eSpark-Backup/enlilishaya-windmillcircuit/Design-Files/Design-v2.1/Deliverables/Impedance profile/50 Ohms net_names.PNG

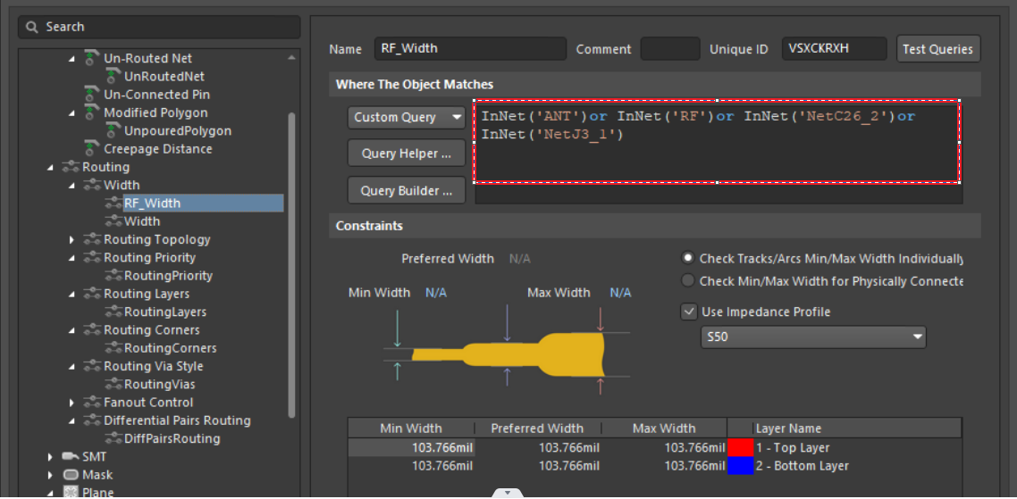
Design-Files/Design-v2.1/Deliverables/Impedance profile/50 Ohms net_names.PNG
