eSpark-Backup/enlilishaya-windmillcircuit/Design-Files/Design-v2.1/Deliverables/Renderings/3D_Top_View.PNG

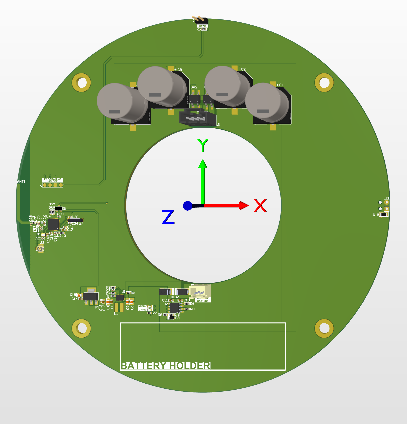
Design-Files/Design-v2.1/Deliverables/Renderings/3D_Top_View.PNG
