eSpark-Backup/enlilishaya-windmillcircuit/Design-Files/Design-v2.1/Deliverables/Renderings/Dimension.PNG

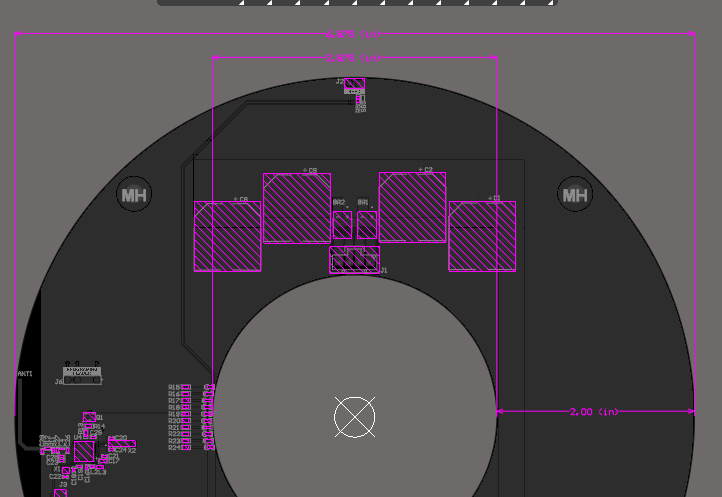
Design-Files/Design-v2.1/Deliverables/Renderings/Dimension.PNG
