eSpark-Backup/enlilishaya-windmillcircuit/Design-Files/Design-v2.1/Deliverables/BOM/Client-BOM-Design-v2.1.xlsx

# | Item Type | Designator | Description | Footprint | Manufacturer Part Number | Manufacturer | Value | Quantity | Remarks
1 | Bridge Rectifier | BR1, BR2 | 50A 700mV@2A 2A 60V MBS Bridge Rectifiers ROHS | Custom | MB26S | MDD | - | 2
2 | Capacitor | C1, C2, C8, C9 | 2200uF 25V 720mA@120Hz ±20% SMD,D16xL16.5mm Aluminum Electrolytic Capacitors - SMD ROHS | Custom | VT1E222M1616 | ROQANG | 2200uF | 4
3 | Capacitor | C3, C10, C11, C12, C14 | CAP CER 10UF 16V X5R 0603 | Cap-0603 | CC0603KRX5R7BB106 | Yageo | 10uF | 5
4 | Capacitor | C4 | CAP CER 47UF 10V X5R 0805 | Cap-0805 | GRM21BR61A476ME15L | Murata | 47uF | 1
5 | Capacitor | C5, C6, C15 | CAP CER 22UF 25V X5R 0805 | Cap-0805 | CC0805MKX5R8BB226 | Yageo | 22uF | 3
6 | Capacitor | C7, C13, C19, C21, C29 | CAP CER 0.1UF 50V X7R 0402 | cap-0402 | C1005X7R1H104KT000F | TDK | 100nF | 5
7 | Capacitor | C16 | CAP CER 1UF 25V X5R 0402 | Cap-0402 | CL05A105KA5NQNC | Samsung | 1uF | 1
8 | Capacitor | C17 | CAP CER 4.7UF 25V X5R 0603 | Cap-0603 | CL10A475KA8NQNC | Samsung | 4.7UF | 1
9 | Capacitor | C18, C22 | CAP CER 12PF 50V C0G/NP0 0402 | Cap-0402 | GJM1555C1H120GB01D | Murata | 12pF | 2
10 | Capacitor | C20, C24 | 50V 9pF C0G 0402 Multilayer Ceramic Capacitors MLCC - SMD/SMT ROHS | Cap-0402 | 0402CG9R0C500NT | FH (Guangdong Fenghua Advanced Tech) | 9pF | 2
11 | Capacitor | C23 | CAP CER 100PF 50V C0G/NPO 0402 | Cap-0402 | CC0402JRNPO9BN101 | Yageo | 100pF | 1
12 | Capacitor | C25, C27 | CAP CER 0.1UF 50V X7R 0402 | cap-0402 | C1005X7R1H104KT000F | TDK | DNP | 2 | DO NOT PLACE
13 | Capacitor | C26 | CAP CER 0.8PF 50V C0G/NPO 0402 | Cap-0402 | CC0402BRNPO9BNR80 | Yageo | 0.8pF | 1
14 | Capacitor | C28 | CAP CER 1.2PF 50V C0G/NPO 0402 | Cap-0402 | CC0402BRNPO9BN1R2 | Yageo | 1.2pF | 1
15 | Diode | D1, D2 | 60V 700mV@2A 2A SMA(DO-214AC) Schottky Barrier Diodes (SBD) ROHS | SMA(DO-214AC) | SS26 | MDD | - | 2
16 | Diode | D3 | DIODE ZENER 3.3V 200MW SOD323F | SOD323F | MM3Z3V3B | ON Semiconductor / Fairchild | - | 1
17 | Wire to Board Connector | J1 | 1x4P 4P 1 Tin 2.54mm 4 3A Brass Direct Insert Plugin,P=2.54mm Wire To Board Connector ROHS | Custom | X9556WV-04-N0V01 | XKB Connection | - | 1
18 | Male Header | J2 | Gold 250V 3A Straight Square Pins 2.5mm 2P 260℃ 6mm -40℃~+105℃ 3mm 2.54mm Plugin Black Brass 1x2P Plugin,P=2.54mm Pin Headers ROHS | HDR1X2_ | X6511WV-02H-C60D30 | XKB | - | 1
19 | UFL Connector | J3 | CONN U.FL RCPT STR 50 OHM SMD | Custom | U.FL-R-SMT-1(80) | Hirose | - | 1
20 | JST Connector | J5 | Conn Shrouded Header (4 Sides) HDR 2 POS 2.5mm Solder ST Thru-Hole Box | Custom | B2B-XH-A(LF)(SN) | JST | - | 1
21 | Pogo Connector | J6 | Pogo Pad 2.5mm 4 Pin | Custom | POGO Connector 4 Pin |  | - | 1
22 | Inductor | L1 | 6A 1.5uH ±20% 10.5A SMD,4.1x4.1mm Power Inductors ROHS | Custom | FTC404020S1R5MGCA | cjiang (Changjiang Microelectronics Tech) | 1.5uH | 1
23 | Inductor | L2 | FIXED IND 15NH 400MA 0.45OHM SMD | IND-0402 | LQG15HN15NJ02D | Murata | 15nH | 1
24 | Inductors | L3 | FIXED IND 10UH 80MA 360 MOHM SMD | IND-0603 (1608 Metric) | LBMF1608T100K | Taiyo Yuden | 10uH | 1
25 | Inductors | L4 | FIXED IND 3.9NH 350MA 350MOHM SM | IND-0201 | LQP03TG3N9B02D | Murata | 3.9nH | 1
26 | LED | LED1 | Emerald 0603 Light Emitting Diodes (LED) ROHS | LED-0603 | NCD0603G2 | Foshan NationStar Optoelectronics | - | 1
27 | LED | LED2 | RED LED 0603 Light Emitting Diodes | LED-0603 | NCD0603R3 | Foshan NationStar Optoelectronics | - | 1
28 | Mosfet | Q1 | Trans Mosfet P-ch 30V 4A 3-PIN SOT-23 T/r | SOT-23 | AO3401A | Alpha & Omega Semiconductor | - | 1
29 | Resistor | R1 | RES SMD 523K OHM 0.1% 1/10W 0603 | Res-0603 | RT0603BRD07523KL | Yageo | 523K | 1
30 | Resistor | R2 | RES 100K OHM 1% 1/10W 0603 | Res-0603 | RC0603FR-07100KL | Yageo | 100K | 1
31 | Resistor | R3, R10, R14 | RES SMD 10K Ohm 1% 1/10W 0603 | Res-0603 | RC0603FR-0710KL | Yageo | 10K | 3
32 | Resistor | R4 | RES SMD 100K OHM 0.1% 1/10W 0603 | Res-0603 | RT0603BRD07100KL | Yageo | 100K | 1
33 | Resistor | R5 | RES SMD 330R 100 mW 0603 | Res-0603 | RC0603JR-07330RL | Yageo | 330R | 1
34 | Resistor | R6 | RES 0.47 OHM 5% 1/10W 0603 | Res-0603 | RL0603JR-070R47L | Yageo | 0.47R | 1
35 | Resistor | R7 | RES SMD 1K OHM 1% 1/10W 0603 | Res-0603 | RC0603FR-071KL | Yageo | 1K | 1
36 | Resistor | R8 | RES SMD 2K OHM 1% 1/10W 0603 | Res-0603 | RC0603FR-072KL | Yageo | 2K | 1
37 | Resistor | R9 | RES SMD 33K OHM 0.1% 1/10W 0603 | Res-0603 | RT0603BRD0733KL | Yageo | 33K | 1
38 | Resistor | R11 | RES 0 OHM JUMPER 1/16W 0402 | Res-0402 | RC0402FR-070RL | Yageo | DNP | 1 | DO NOT PLACE
39 | Resistor | R12 | RES 0 OHM JUMPER 1/16W 0402 | Res-0402 | RC0402FR-070RL | Yageo | 0R | 1
40 | Resistor | R13 | RES 4.7 OHM 1% 1/10W 0603 | Res-0603 | RC0603FR-074R7L | Yageo | 4.7R | 1
41 | Resistor | R15 | RES 8.2 OHM 1% 1/4W 1206 | Res-1206 | RC1206FR-078R2L | Yageo | 8.2R | 1
42 | IC | U1 | IC REG BCK BST ADJ 3.6A 15VQFN | VQFN-15-HR(2.5x3) | TPS63070RNMR | Texas Instruments | - | 1
43 | IC | U2 | 3.7V~6.5V Lithium-ion 1 1000mA ESOP-8 Battery Management ROHS | ESOP-8 | TP4056 | UMW(Youtai Semiconductor Co., Ltd.) | - | 1
44 | IC | U3 | 15V 1.3V @ 800mA Fixed 3.3V SOT-223 Linear Voltage Regulators (LDO) ROHS | SOT- 223 | AZ1117CH-3.3TRG1 | Diodes Incorporated | - | 1
45 | IC | U4 | IC RF TXRX+MCU BLE 32QFN | 32-QFN (5x5) | NRF52810-QCAA-R | Nordic Semiconductor | - | 1
46 | Crystal | X1 | CRYSTAL 32.0000MHZ 8PF SMD | SMD2016-4P | Q22FA12800025 | Epson | 32MHz | 1
47 | Crystals | X2 | 32.768kHz 7pF ±20ppm MC-146 Crystals ROHS | MC-146_ | Q13MC14620001 | Seiko Epson | 32.768kHz | 1
48 | Peripheral | - | Zetiling High Power Led Chip | - | B07TKL2JRM | Zetiling | - | 10 | B07TKL2JRM (https://www.amazon.com/dp/B01DBZI2A0?previewDohEventScheduleTesting=C&csmig=1)
48 | Peripheral | - | Sanyo Stepper Motor w/ 17.5mm 20 Tooth Gear - 12 V - 7.5 deg / step - 42mm D | - | B00224 | Sanyo | - | 1 | B00224 (https://www.ebay.com/itm/284742127006)
