eSpark-Backup/enlilishaya-windmillcircuit/Design-Files/Design-v2.1/Deliverables/Supporting Files/Windmill_Circuit_v2.1.step

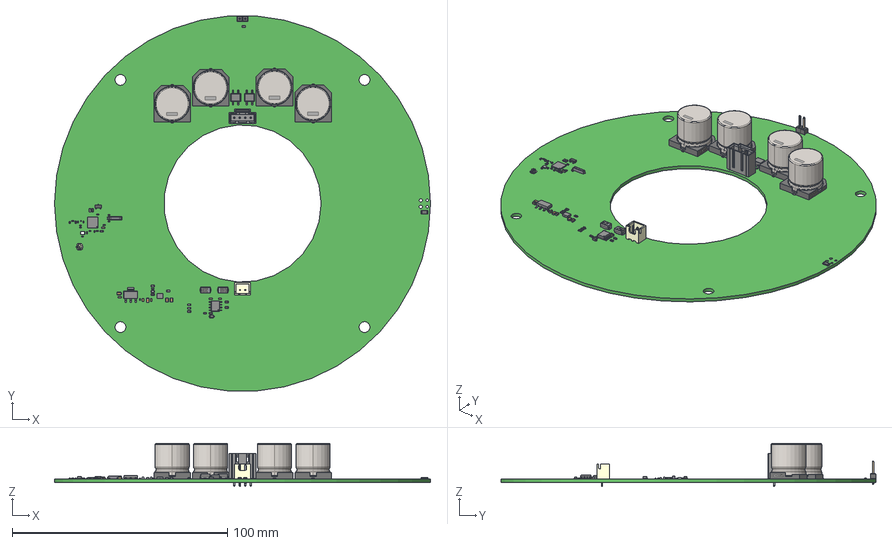
[picture p10: CAD file, 2025-07-11]
Design-Files/Design-v2.1/Deliverables/Supporting Files/Windmill_Circuit_v2.1.step
174.6 x 174.1 x 20.0 mm
User Library-SOD323F-1
User Library-CR3216-1206
User Library-RESC1608X05N x 12
CircuitWorks-SOT-23
Crystal_SMD_SeikoEpson_MC146-4Pin_6.7x1.5mm x 4
TCA6424ARGJR
User Library-SOT-223-1
User Library-RES_1005-0402 x 2
Ferrite
Lötende x 2
base
User Library-d0402h025
User Library-Capacitor 0402 x 15
User Library-CAPC1608X09 x 6
User Library-0805 SMD Capacitor x 4
TP4056-42-ESOP8--3DModel-STEP-56544
TPS63070RNMR--3DModel-STEP-56544
User Library-LED SMD0603 x 2
B2B-XH-A(LF)(SN)--3DModel-STEP-56544
U.FL-R-SMT-1
User Library-Header1x2_Header1_1 x 2
SMA (DO-214AC) x 2
SOLID.step x 2
