eSpark-Backup/enlilishaya-windmillcircuit/(list of files, cad)

Other CAD files:
Design-Files/Design-v2.1/Deliverables/Supporting Files/Windmill_Circuit_v2.1.DWG
Design-Files/Design-v2.1/Deliverables/Supporting Files/Windmill_Circuit_v2.1.DXF
