eSpark-Backup/enlilishaya-windmillcircuit/Design-Files/Design-v2.1/Schematic/Design-v2.1.pdf

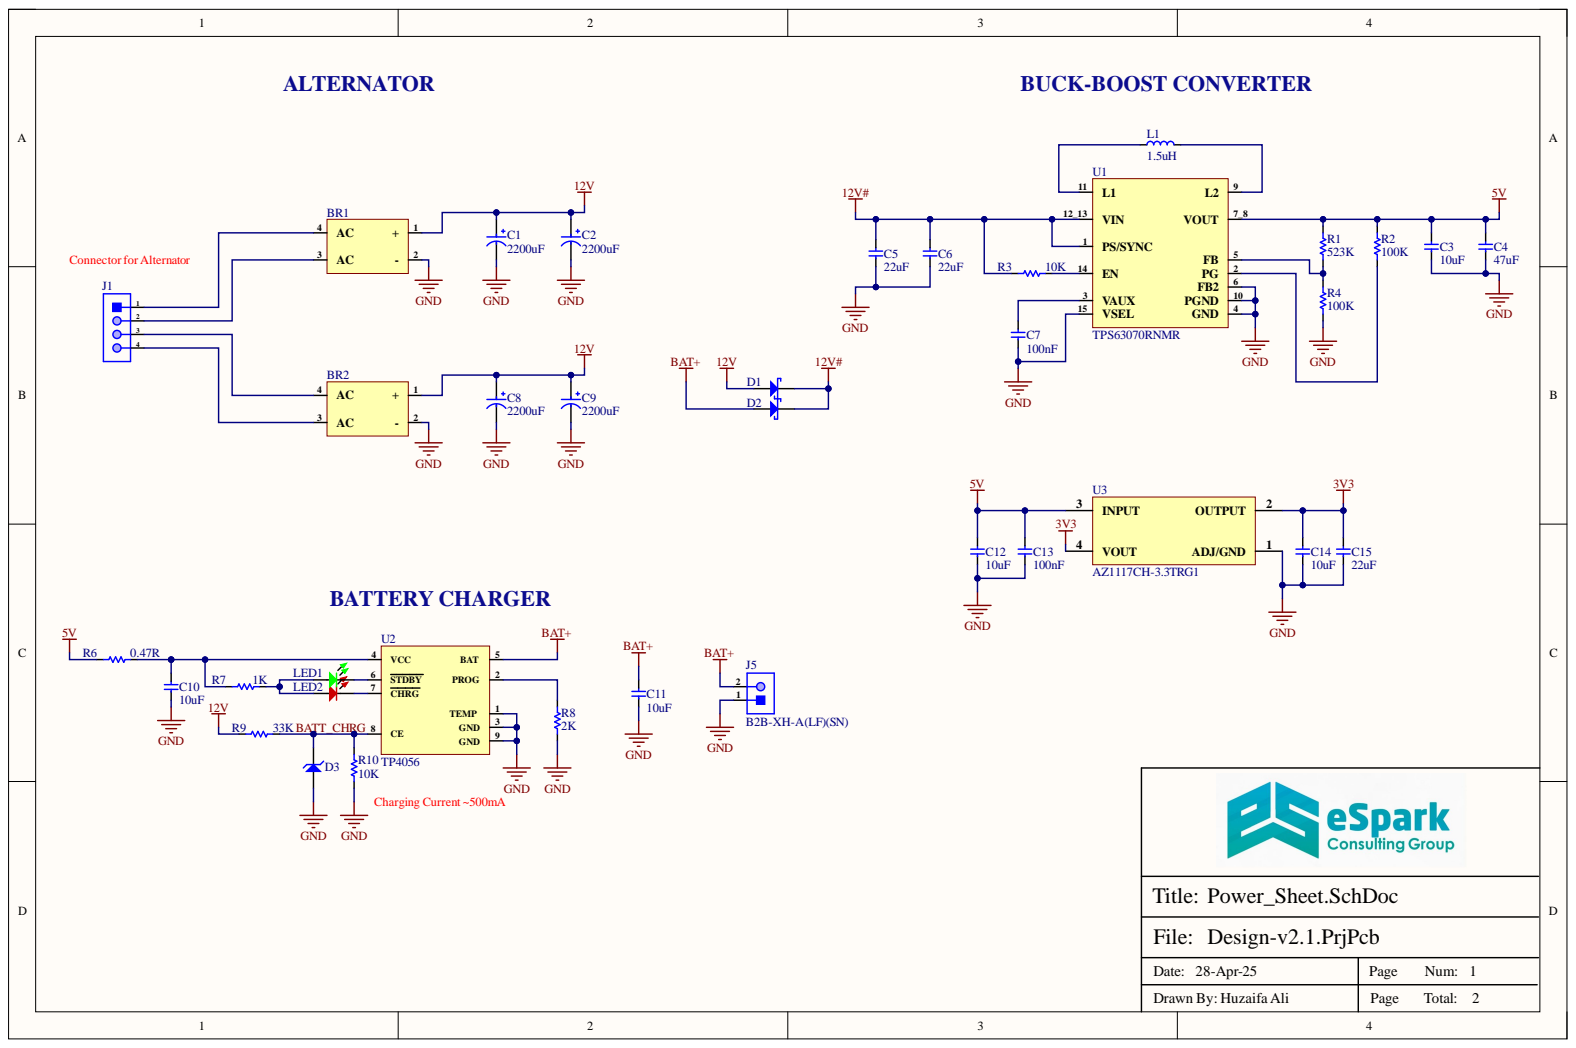
[picture p11: page 1]

Dat e : 2 8 -A p r-2 5 | Pag e N u m : 12

D raw n B y : H uzai fa A l i | Pag e To t al :

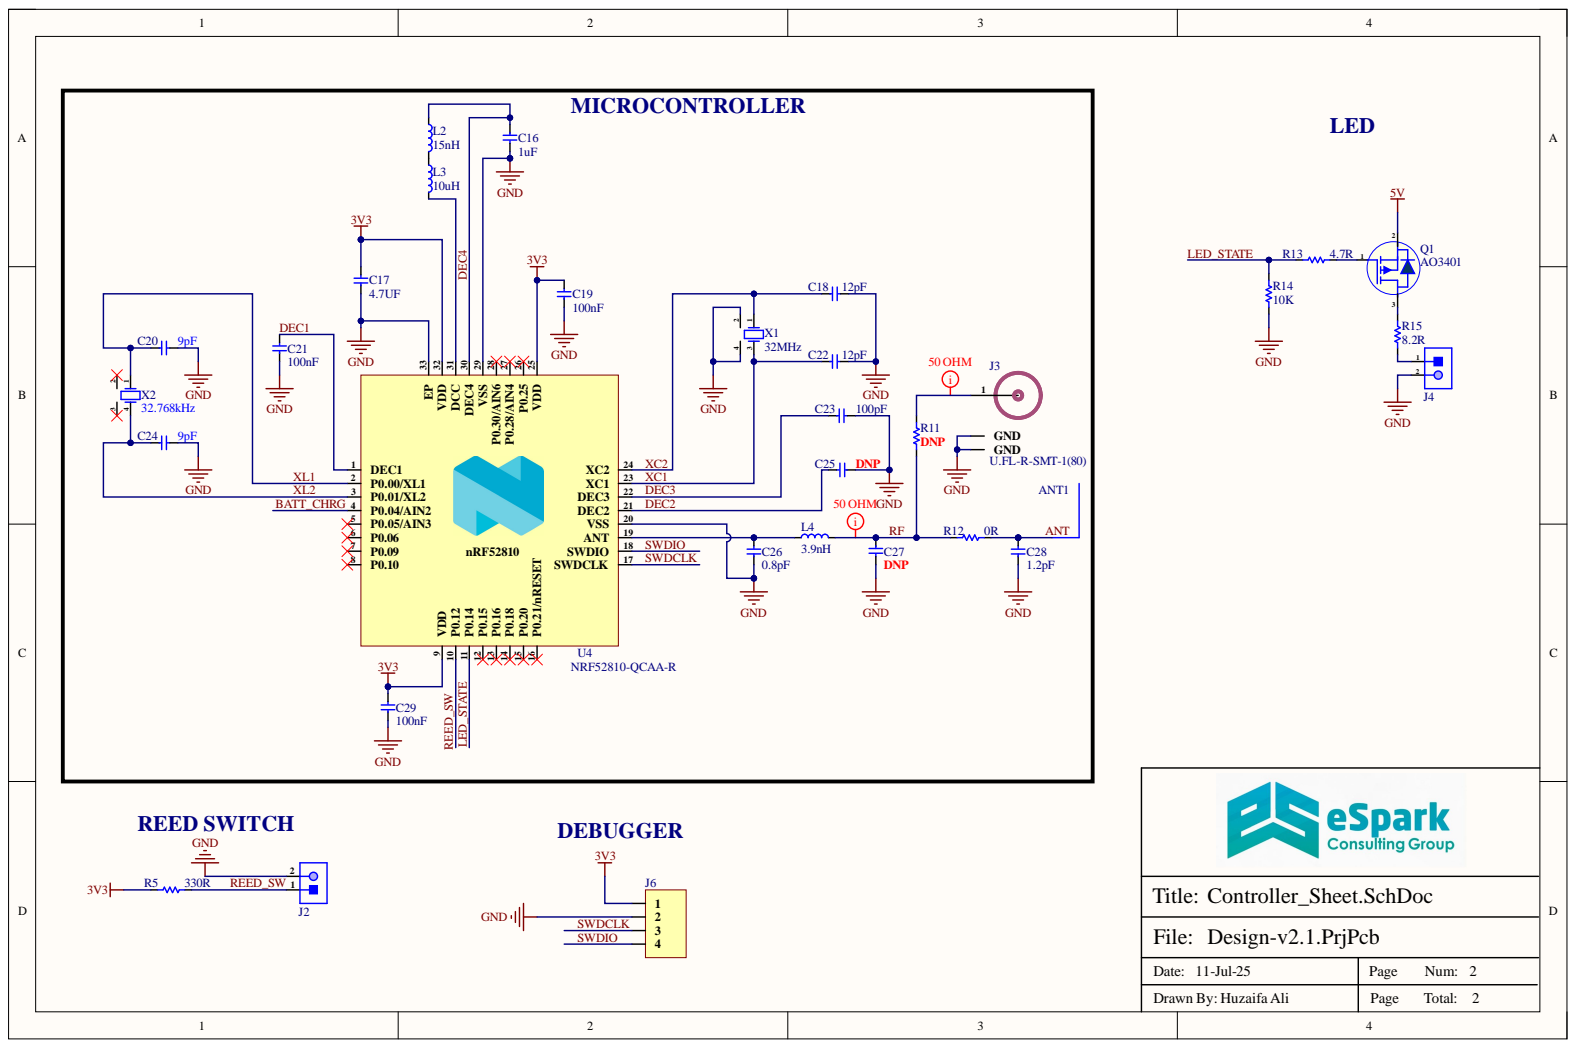
[picture p12: page 2]

Dat e : 1 1 -Ju l -2 5 | Pag e N u m : 22

D raw n B y : H uzai fa A l i | Pag e To t al :
