eSpark-Backup/enlilishaya-windmillcircuit/Design-Files/Design-v2.1/Deliverables/Schematics/Assembly_Drawing.pdf

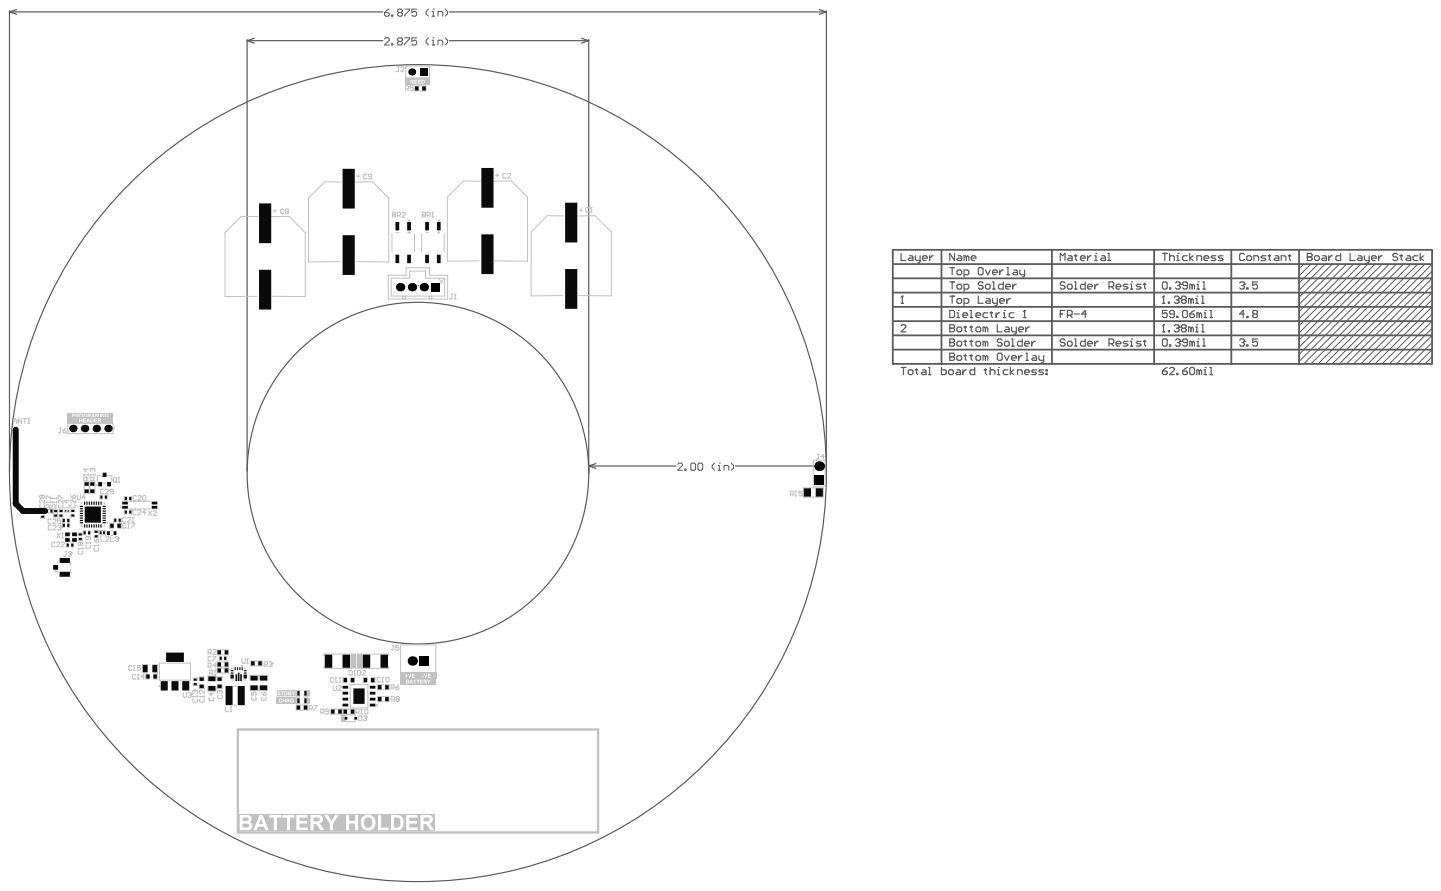
[picture p13: page 1]

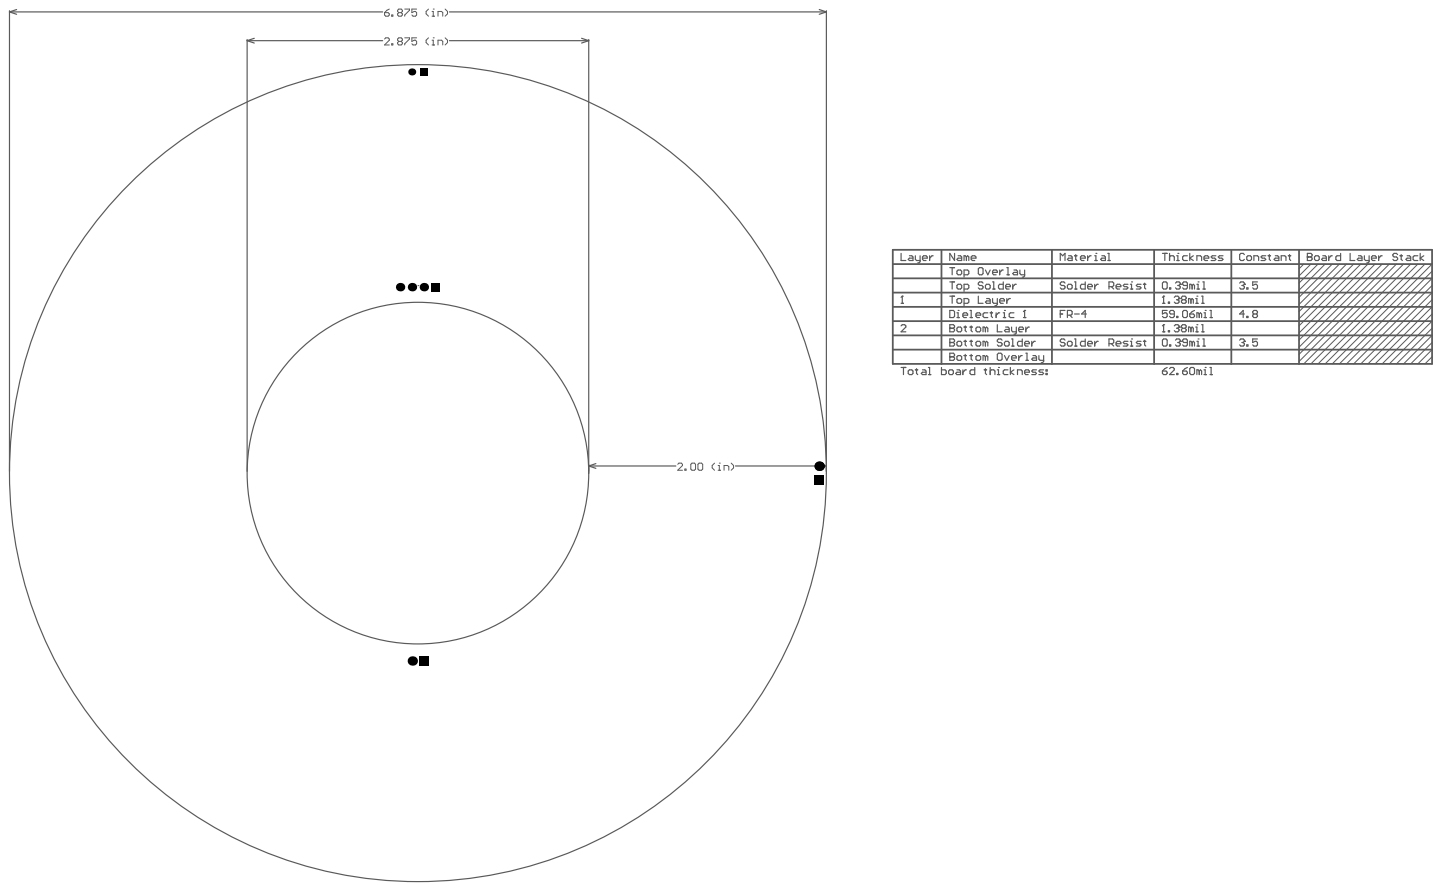
[picture p14: page 2]
