eSpark-Backup/enlilishaya-windmillcircuit/Design-Files/Design-v2.1/Deliverables/Schematics/Design-v2.1.pdf

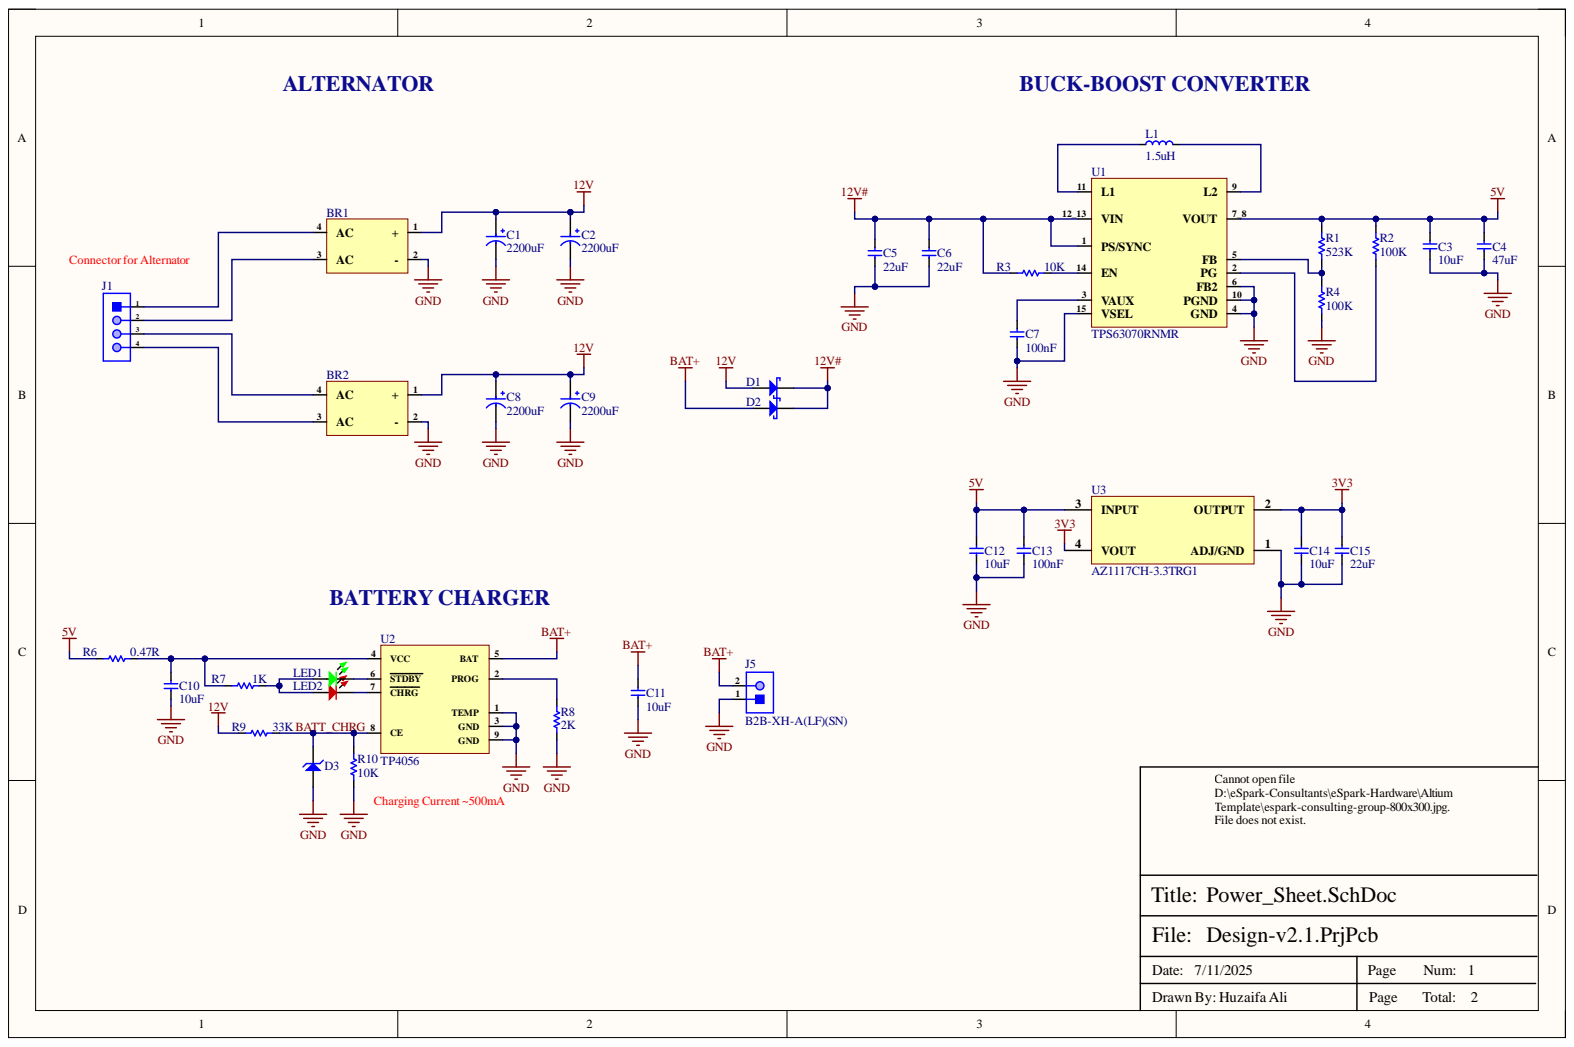
[picture p15: page 1]

Dat e : 7 / 1 1 / 2 0 2 5 | Pag e N u m : 12

D raw n B y : H uzai fa A l i | Pag e To t al :

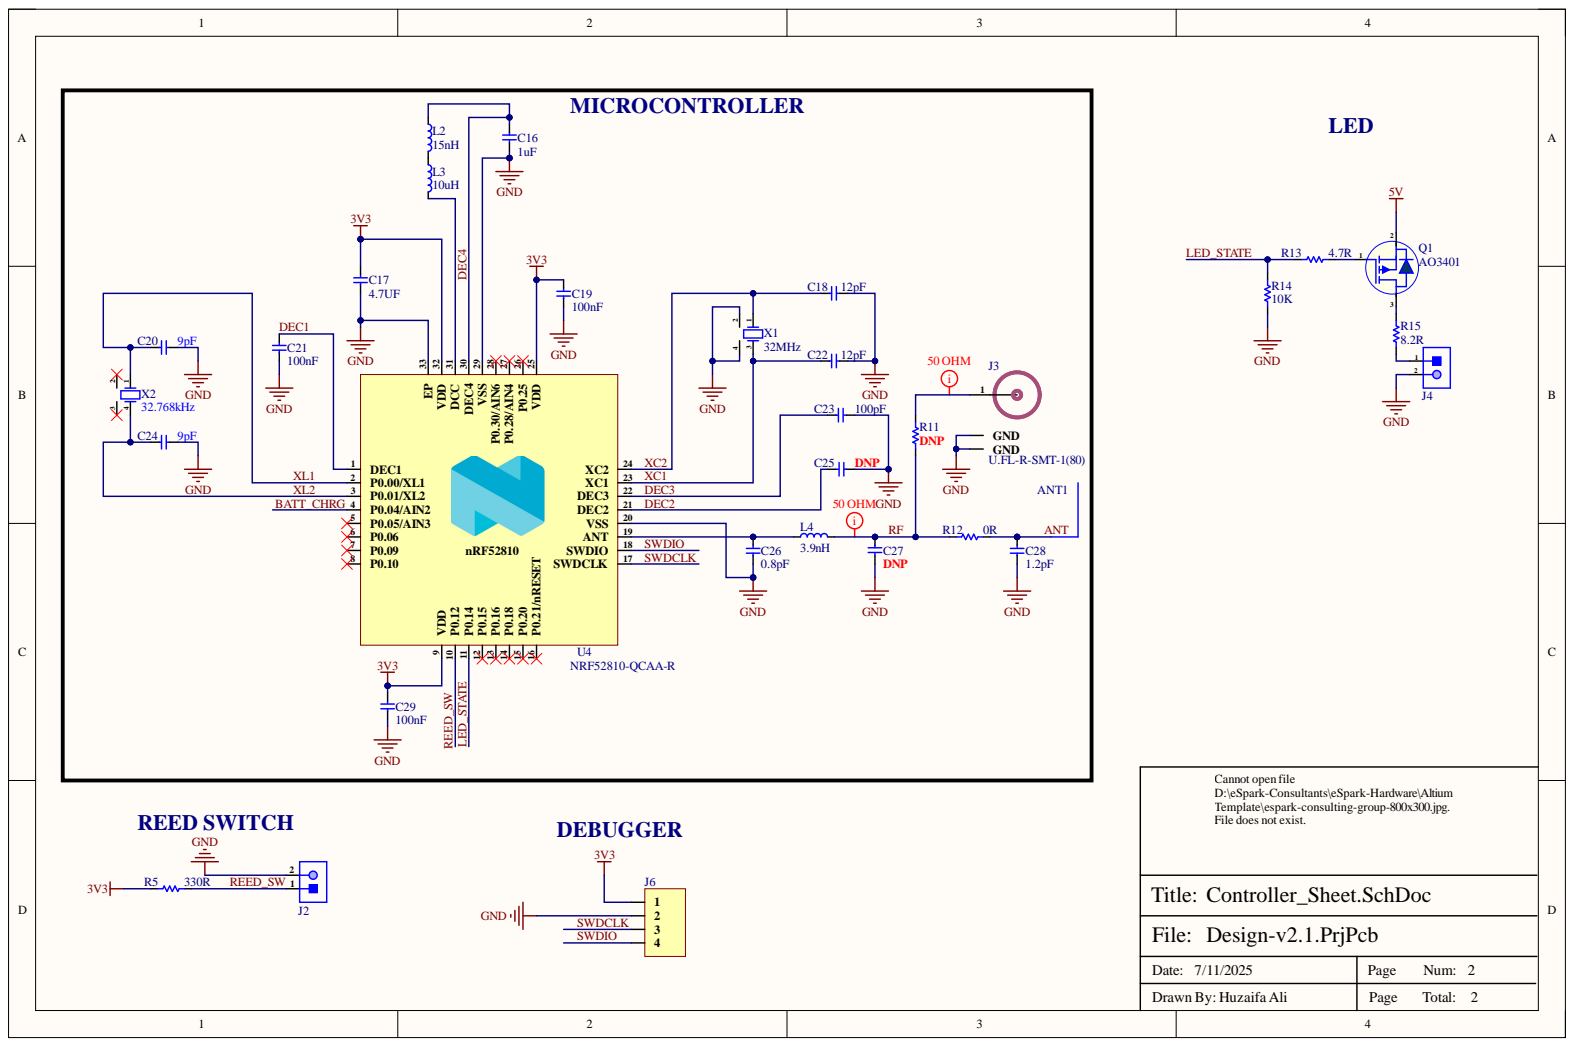
[picture p16: page 2]

Dat e : 7 / 1 1 / 2 0 2 5 | Pag e N u m : 22

D raw n B y : H uzai fa A l i | Pag e To t al :

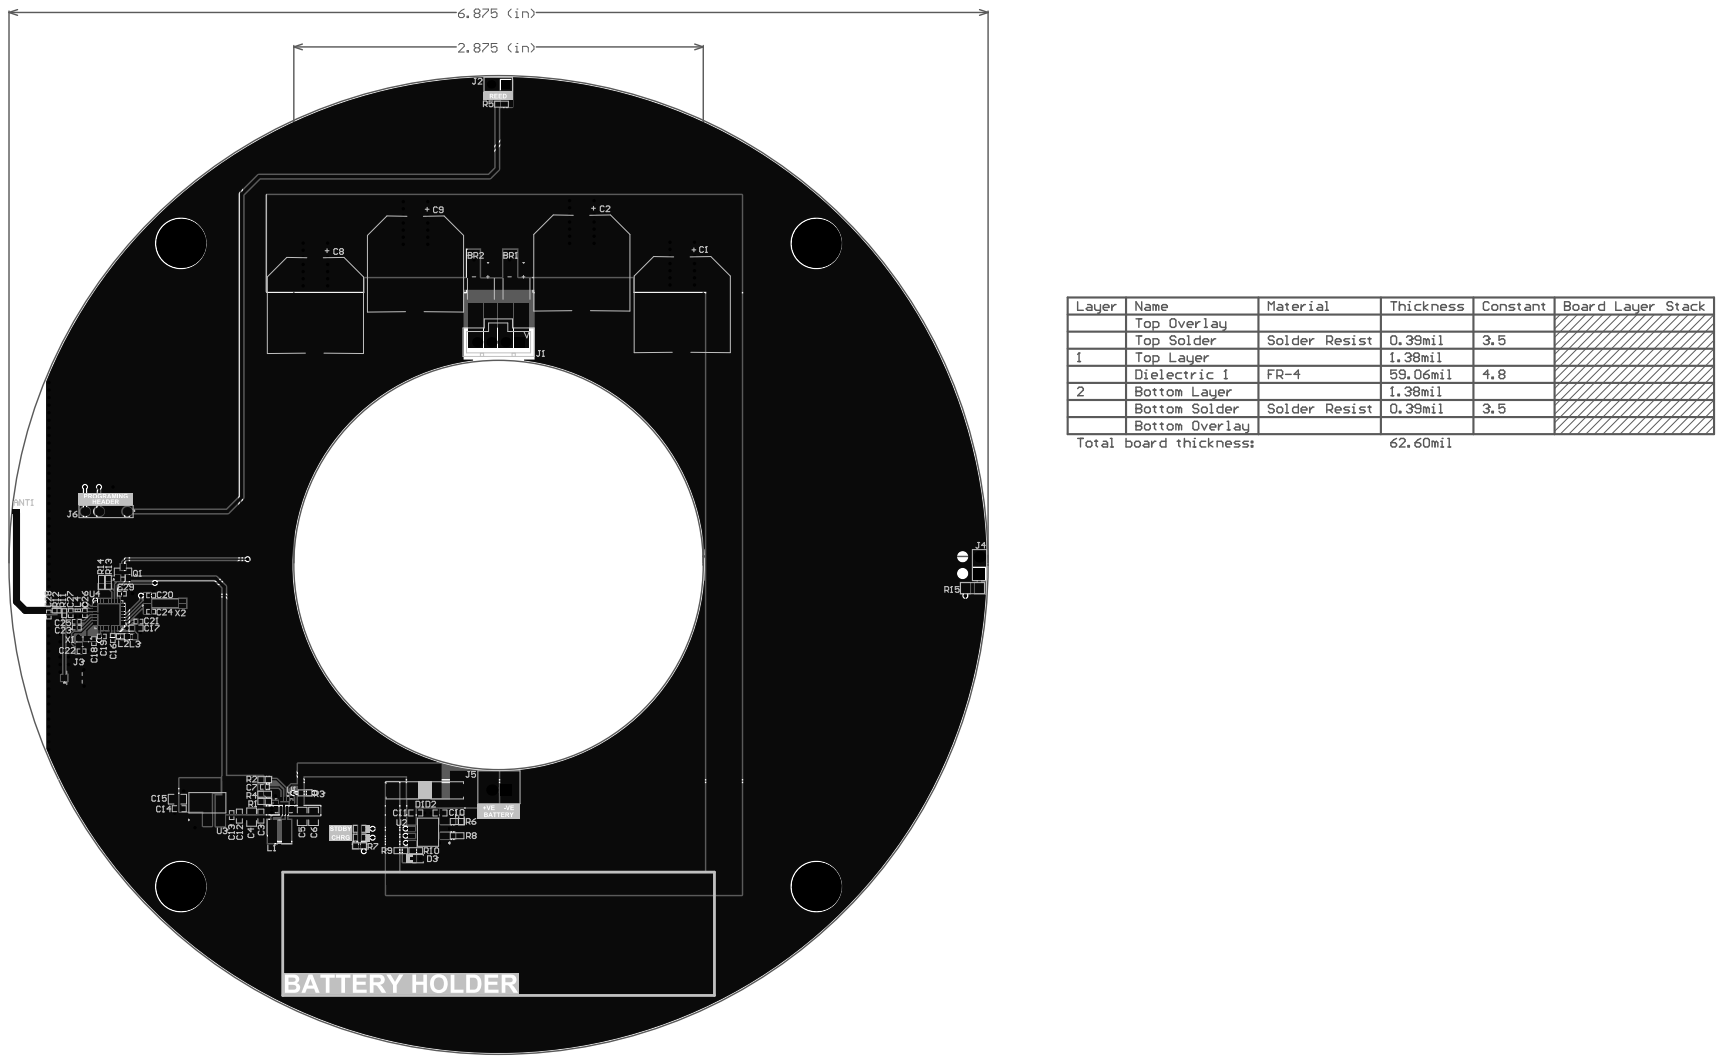
[picture p17: page 3]
