eSpark-Backup/enlilishaya-windmillcircuit/(list of files, drawings)

Other design files:
Design-Files/Design-v1.0/Design-v1.0.PrjPcb
Design-Files/Design-v2.0/Design-v2.0.PrjPcb
Design-Files/Design-v2.1/Controller_Sheet.SchDoc
Design-Files/Design-v2.1/Design-v2.1.PrjPcb
Design-Files/Design-v2.1/Power_Sheet.SchDoc
Design-Files/Design-v2.1/Windmill_Circuit_v2.1.PcbDoc
