eSpark-Backup/enlilishaya-windmillcircuit/(commit log)

2025-04-07 #2 Complete
    [Design-v1.0.PrjPcb, Sheet1.SchDoc]
2025-04-07 #2 Resistor Update. PDF Generated.
    [Design-v1.0.PrjPcb, Sheet1.SchDoc]
2025-04-08 #3 In progress
    [Design-v1.0.PrjPcb, Windmill_Circuit_v1.0.PcbDoc]
2025-04-09 #5 Schematic completed
    [Controller_Sheet.SchDoc, Design-v2.0.PrjPcb, Power_Sheet.SchDoc, Sheet1.SchDoc]
2025-04-10 #5 schematic in progress
    [Controller_Sheet.SchDoc, Windmill_Circuit_v1.0.PcbDoc]
2025-04-11 #5 led circuit added
    [Controller_Sheet.SchDoc]
2025-04-11 #6 placement completed
    [Controller_Sheet.SchDoc, Windmill_Circuit_v1.0.PcbDoc]
2025-04-14 #6 In progress
    [Windmill_Circuit_v1.0.PcbDoc]
2025-04-16 #6 Completed Deliverables Generated
    [Centroid_File.csv, Design-v2.0.PrjPcb, Pick Place for Windmill_Circuit_v2.0.csv, Power_Sheet.SchDoc, Windmill_Circuit_v1.0.PcbDoc, Windmill_Circuit_v2.0.DWG, Windmill_Circuit_v2.0.DXF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]
2025-04-24 #6 PCB updated acc: #7 Deliverables Generated
    [Centroid_File.csv, Client_BOM-v2.0.xlsx, Controller_Sheet.SchDoc, Design-v2.0.PrjPcb, Pick Place for Windmill_Circuit_v2.0.csv, Power_Sheet.SchDoc, Windmill_Circuit_v2.0.DWG, Windmill_Circuit_v2.0.DXF]
2025-04-28 #7 TH pads added in schematic
    [Controller_Sheet.SchDoc, Design-v2.0.PrjPcb, Windmill_Circuit_v2.0.PcbDoc]
2025-04-29 #7 PCB updated nd Deliverables generated
    [Centroid_File.csv, Design-v2.0.PrjPcb, Pick Place for Windmill_Circuit_v2.0.csv, Windmill_Circuit_v2.0.DWG, Windmill_Circuit_v2.0.DXF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]
2025-04-29 #7 Peripheral added in BOM
    [Client_BOM-v2.0.xlsx]
2025-07-11 #5 9th Jul 1W LED point added. Old 10 LEDs removed.
    [Centroid_File.csv, Client_BOM-v2.0.xlsx, Controller_Sheet.SchDoc, Design-v2.1.PrjPcb, Pick Place for Windmill_Circuit_v2.0.csv, Power_Sheet.SchDoc, Windmill_Circuit_v2.0.DWG, Windmill_Circuit_v2.0.DXF]
2025-07-11 Client BOM added.
    [Client-BOM-Design-v2.1.xlsx, Client_BOM-v2.0.xlsx]
2025-07-11 #6 Changes updated after #7 Deliverables Generated
    [Centroid_File.csv, Design-v2.1.PrjPcb, Pick Place for Windmill_Circuit_v2.0.csv, Pick Place for Windmill_Circuit_v2.1.csv, Windmill_Circuit_v2.0.DWG, Windmill_Circuit_v2.0.DXF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]
2025-07-18 #7 JLCPCB BOM Added.
    [JLCPCB-BOM-Design-v2.1.xlsx]
2025-07-21 @mars order added in PCBway Cart from eSpark Account .
    [Client-BOM-Design-v2.1.xlsx]
2025-08-04 Client BOM Update and order placed to PCBway cart.
    [Client-BOM-Design-v2.1.xlsx]
